thanhduy1806/BTL_DienTuUngDung/Report/loicamon.tex

\begin{center}
	{\fontsize{24pt}{24pt}\selectfont\textit{Lời cảm ơn}}
\end{center}

Chúng em xin gửi lời cảm ơn chân thành đến thầy Nguyễn Trung Hiếu vì đã hướng dẫn nhóm chúng em về kiến thức trong quá trình thực hiện mô phỏng mạch đo khối lượng
(tiểu ly) trong môn học Điện tử ứng dụng.\\

Nhờ sự tận tâm và nhiệt huyết của thầy, chúng em đã học hỏi được nhiều điều để
có hướng nghiên cứu phù hợp với đề tài hơn. Trong suốt thời gian nghiên cứu,
thầy không chỉ cung cấp cho chúng em những chỉ dẫn chi tiết và thiết thực mà
còn luôn sẵn sàng giải đáp những thắc mắc, giúp chúng em vượt qua những khó
khăn gặp phải. Sự tâm huyết của thầy trên giảng đường cũng như trong công việc
hướng dẫn đã truyền cảm hứng và động lực cho chúng em rất nhiều.\\

Chúng em xin chân thành cảm ơn thầy và chúc thầy luôn dồi dào sức khỏe, thành công
trong sự nghiệp giảng dạy và tiếp tục là ngọn đuốc soi sáng con đường học tập của
chúng em và các thế hệ sinh viên sau này.\\

Mặc dù nhóm đã rất nỗ lực trong quá trình thực hiện, báo cáo khó tránh
khỏi những thiếu sót. Chúng em rất mong nhận được sự góp ý và chỉ dẫn từ 
Thầy để đề tài được hoàn thiện hơn trong tương lai.
\begin{flushright}
    Thành phố Hồ Chí Minh, ngày \the\day\ tháng \the\month\ năm \the\year
\end{flushright}
