thanhduy1806/BTL_DienTuUngDung/Report/chuong6.tex

\chapter{Kết quả thực tế}
Chương 6 thể hiện kết quả đo đạc được từ mạch thực tế, trong điều kiện nhiệt độ 28$^\circ\text{C}$, từ đó so sánh với giá trị mô phỏng được.
\section{Tại khối lượng 0kg}

\begin{figure}[H]
    \centering
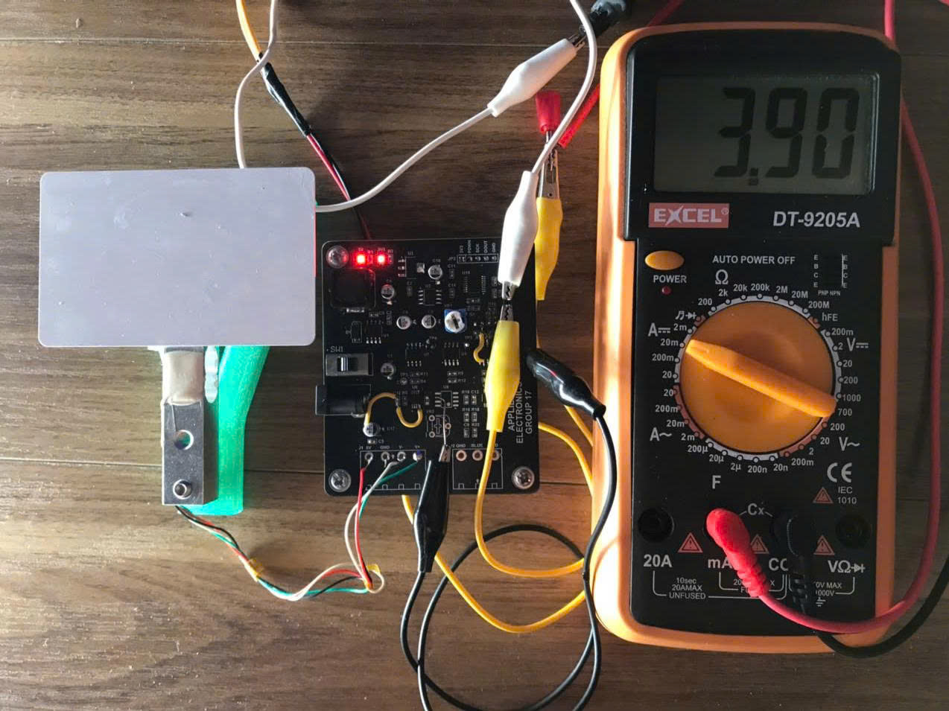
[picture p31: Report/image/real_0.jpg]
    
    \caption{Đo thực tế 0gam}
    \label{fig:real_0}
\end{figure}

\begin{figure}[H]
    \centering
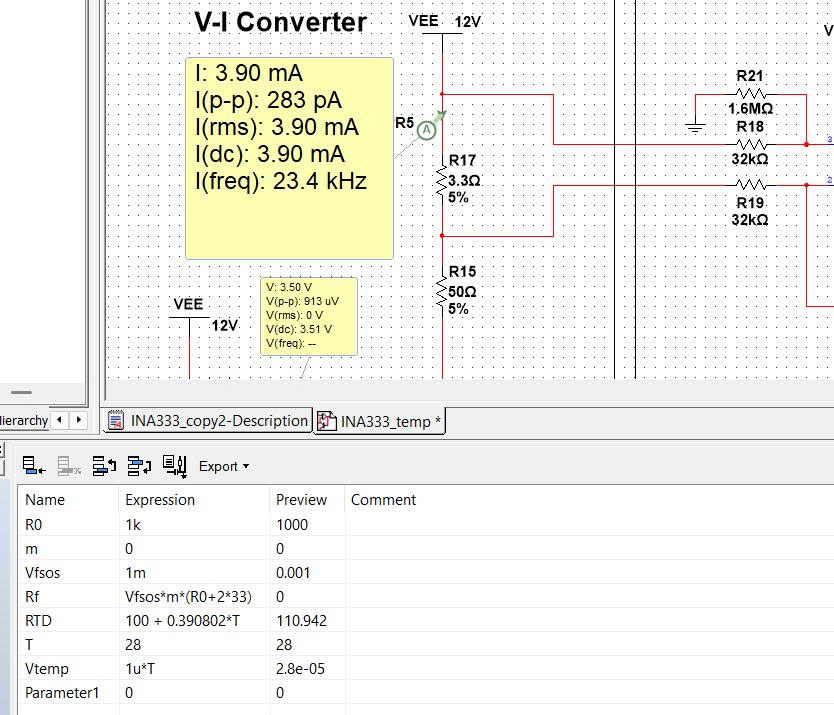
[picture p32: Report/image/sim_0.jpg]
    
    \caption{Mô phỏng 0gam}
    \label{fig:sim_0}
\end{figure}

\section{Tại khối lượng 1gam}

\begin{figure}[H]
    \centering
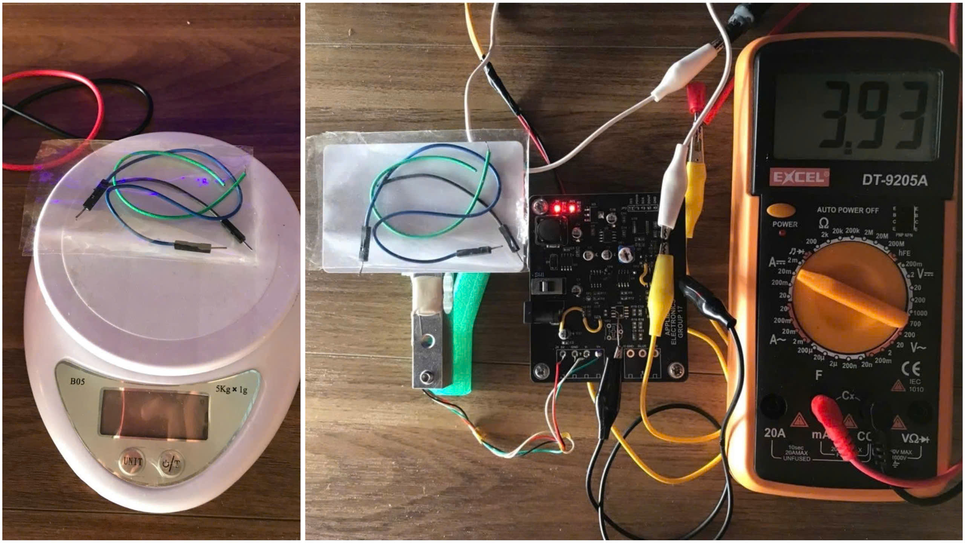
[picture p33: Report/image/real_1gam.jpg]
    
    \caption{Đo thực tế 1gam}
    \label{fig:real_0gam}
\end{figure}

\begin{figure}[H]
    \centering
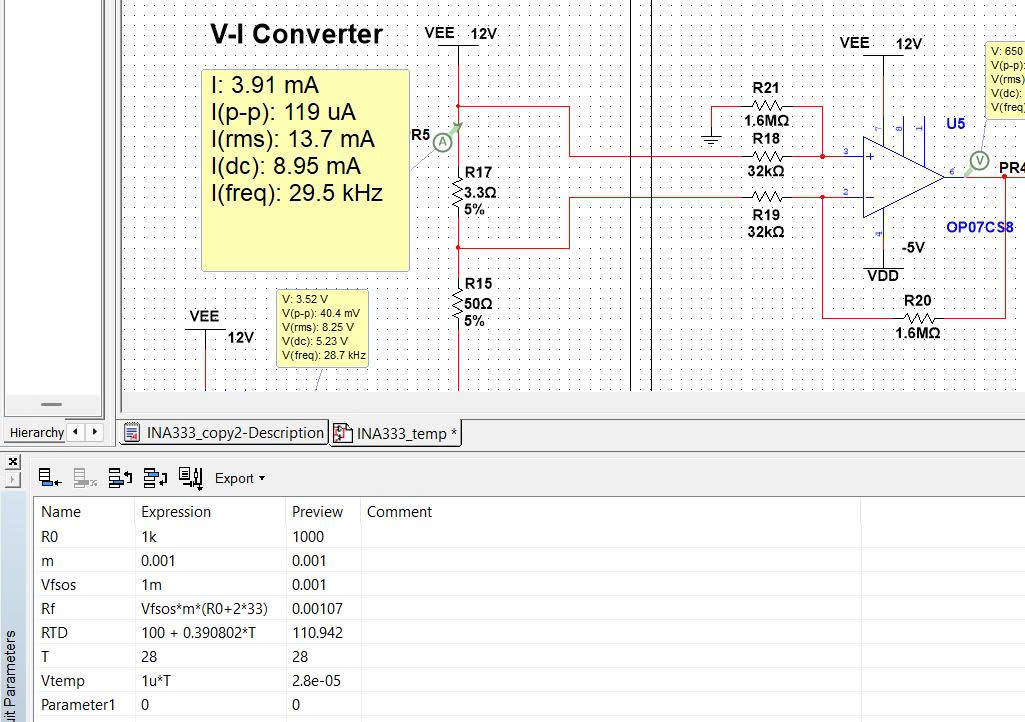
[picture p34: Report/image/sim_1gam.jpg]
    
    \caption{Mô phỏng 1gam}
    \label{fig:sim_1gam}
\end{figure}

\section{Tại khối lượng 3gam}

\begin{figure}[H]
    \centering
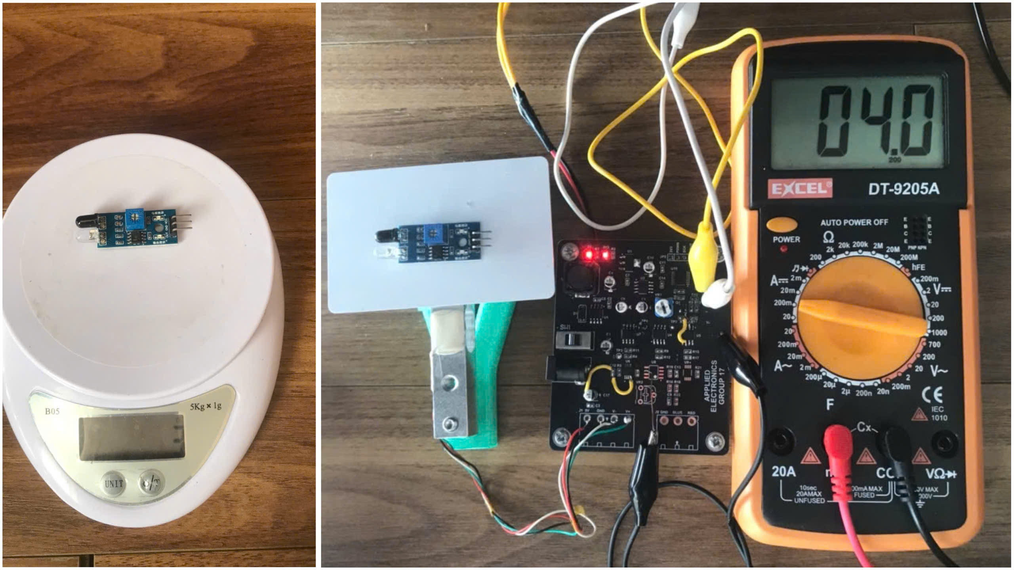
[picture p35: Report/image/real_3gam.jpg]
    
    \caption{Đo thực tế 3gam}
    \label{fig:real_3gam}
\end{figure}

\begin{figure}[H]
    \centering
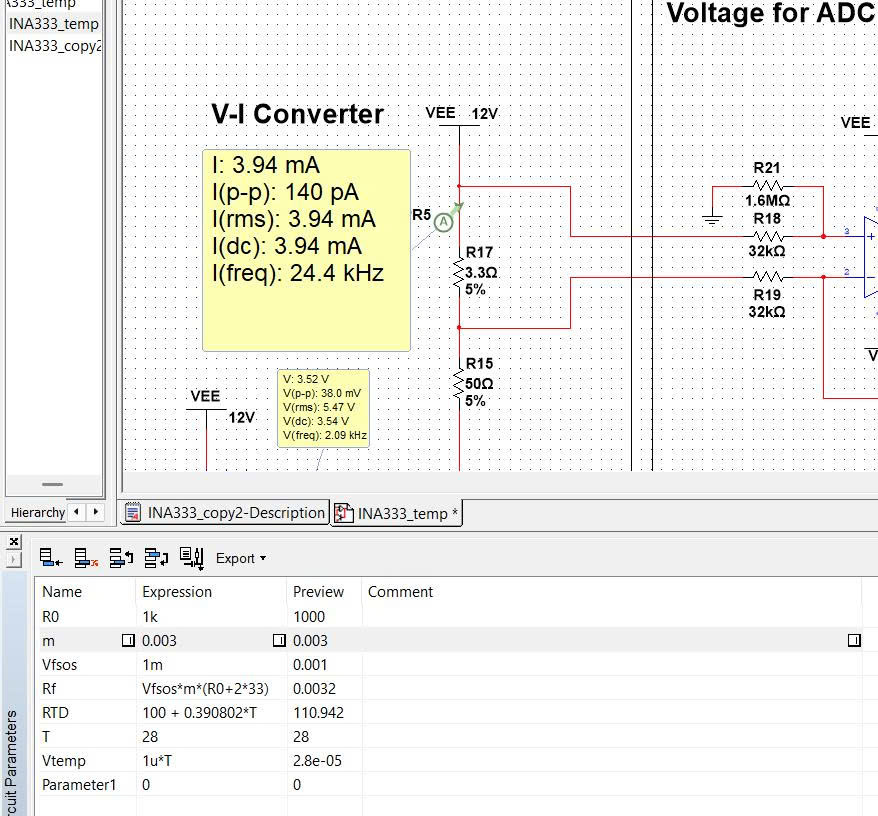
[picture p36: Report/image/sim_3gam.jpg]
    
    \caption{Mô phỏng 3gam}
    \label{fig:sim_3gam}
\end{figure}

\section{Tại khối lượng 81gam}

\begin{figure}[H]
    \centering
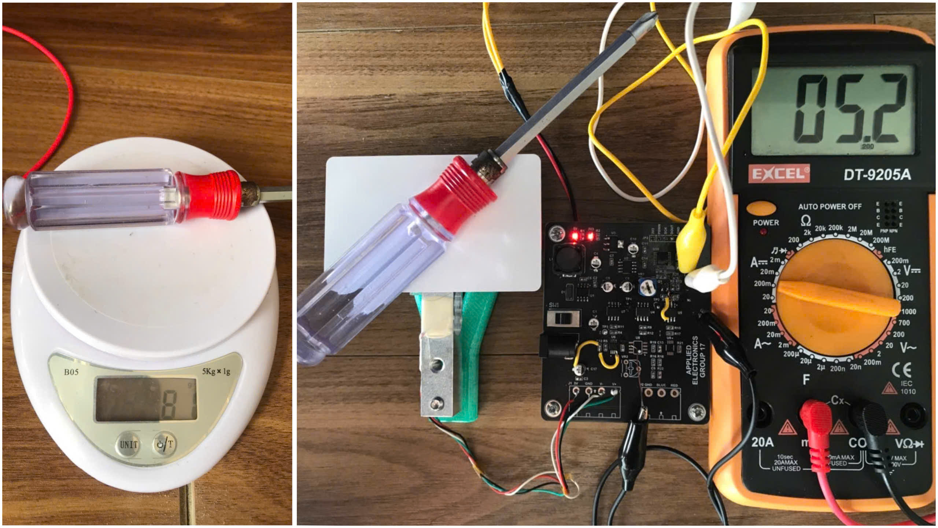
[picture p37: Report/image/real_81gam.jpg]
    
    \caption{Đo thực tế 81gam}
    \label{fig:real_81gam}
\end{figure}

\begin{figure}[H]
    \centering
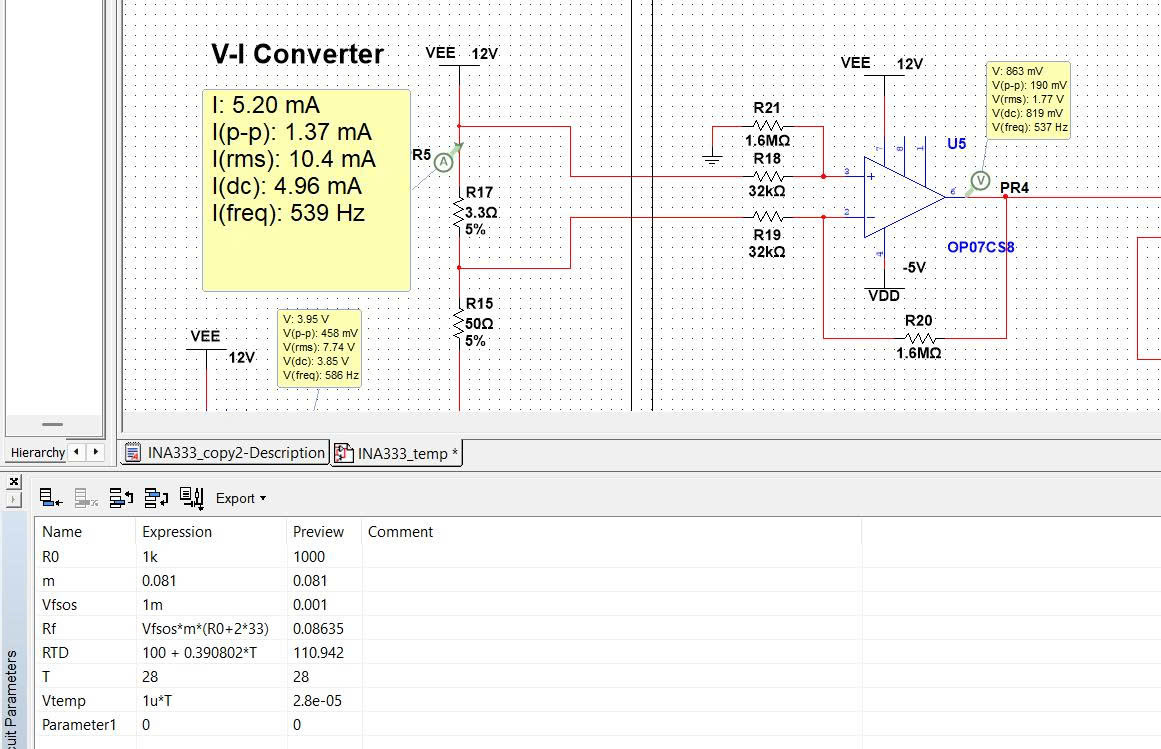
[picture p38: Report/image/sim_81gam.jpg]
    
    \caption{Mô phỏng 81gam}
    \label{fig:sim_81gam}
\end{figure}

\section{Tại khối lượng 95gam}

\begin{figure}[H]
    \centering
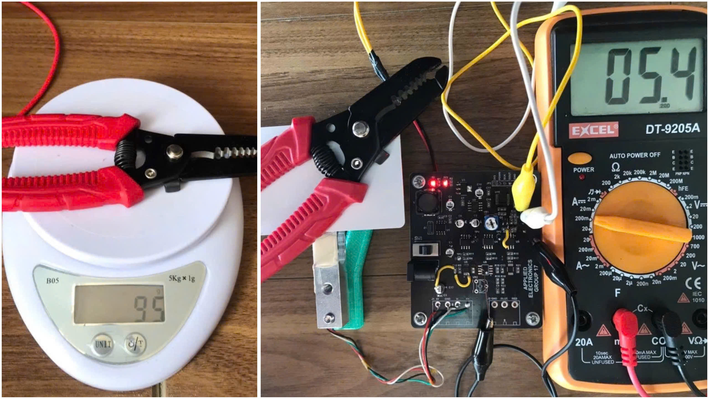
[picture p39: Report/image/real_95gam.jpg]
    
    \caption{Đo thực tế 95gam}
    \label{fig:real_95gam}
\end{figure}

\begin{figure}[H]
    \centering
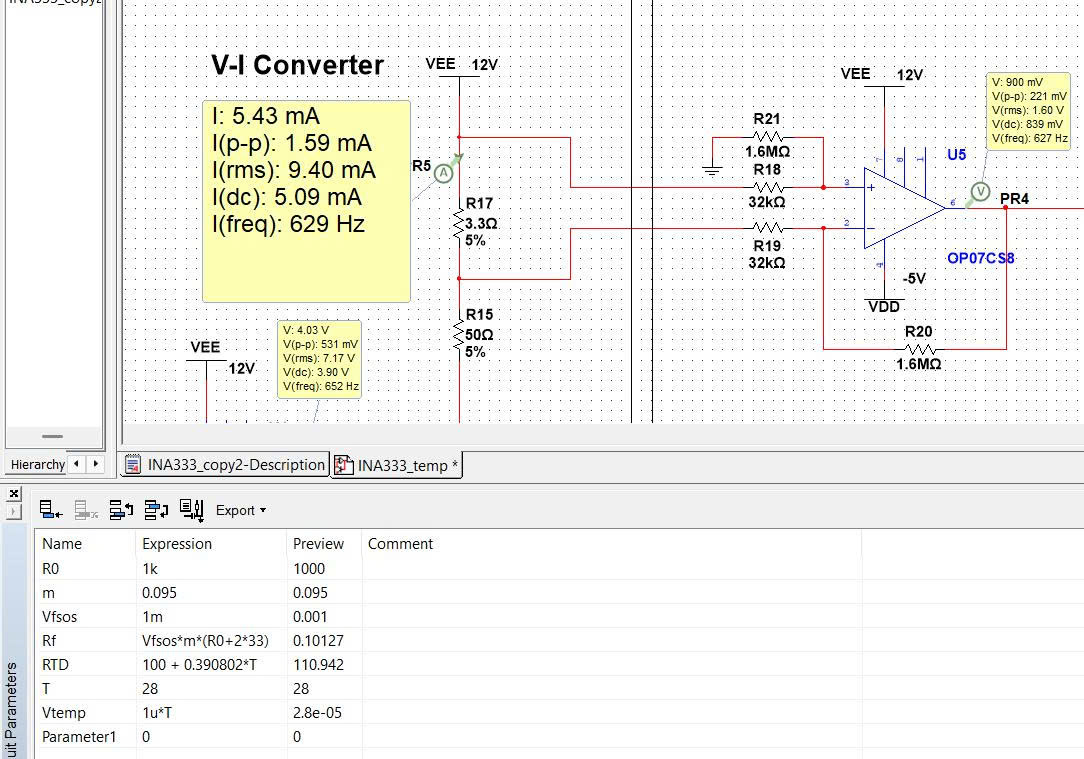
[picture p40: Report/image/sim_95gam.jpg]
    
    \caption{Mô phỏng 95gam}
    \label{fig:sim_95gam}
\end{figure}

\section{Tại khối lượng 100gam}

\begin{figure}[H]
    \centering
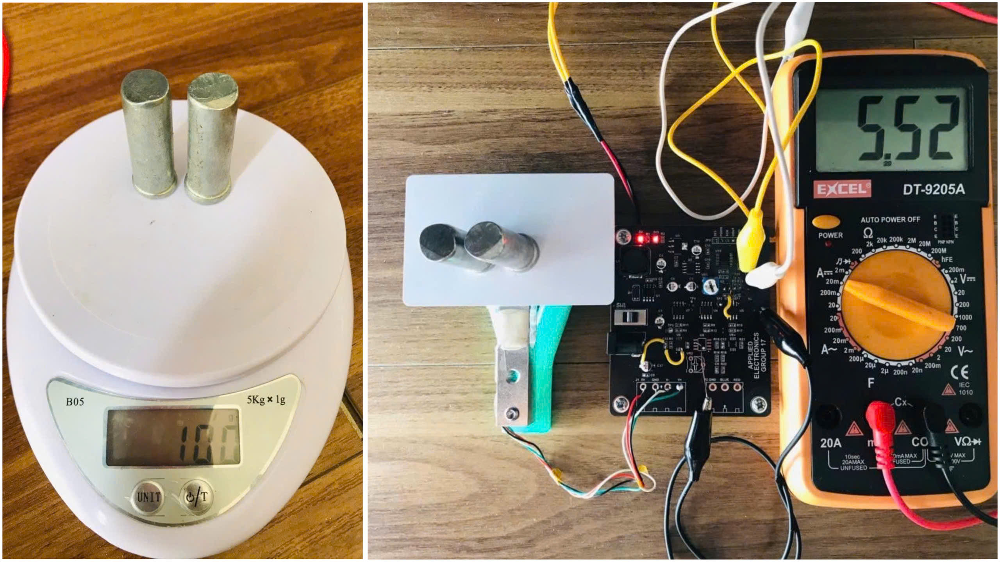
[picture p41: Report/image/real_100gam.jpg]
    
    \caption{Đo thực tế 100gam}
    \label{fig:real_100gam}
\end{figure}

\begin{figure}[H]
    \centering
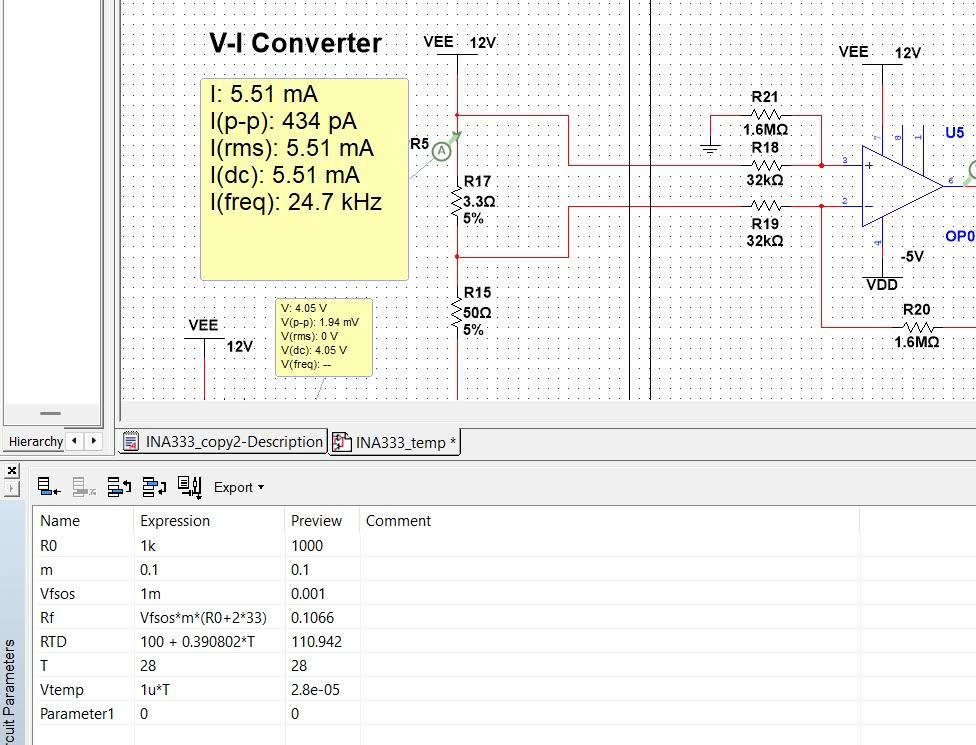
[picture p42: Report/image/sim_100gam.jpg]
    
    \caption{Mô phỏng 100gam}
    \label{fig:sim_100gam}
\end{figure}

\section{Tại khối lượng 163gam}

\begin{figure}[H]
    \centering
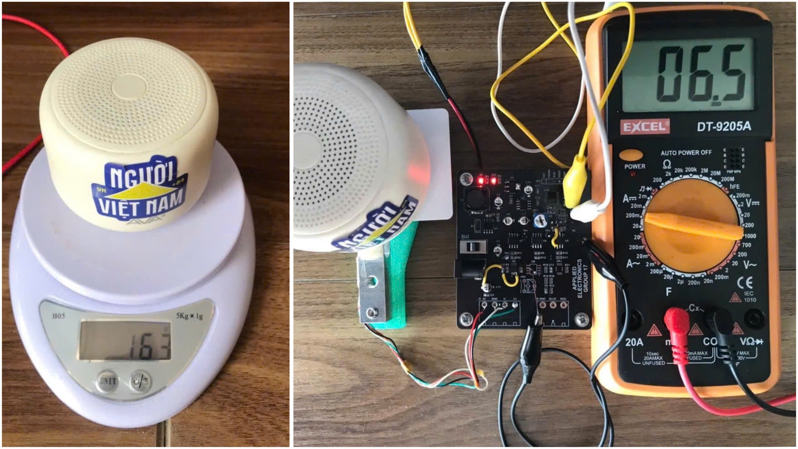
[picture p43: Report/image/real_163gam.jpg]
    
    \caption{Đo thực tế 163gam}
    \label{fig:real_163gam}
\end{figure}

\begin{figure}[H]
    \centering
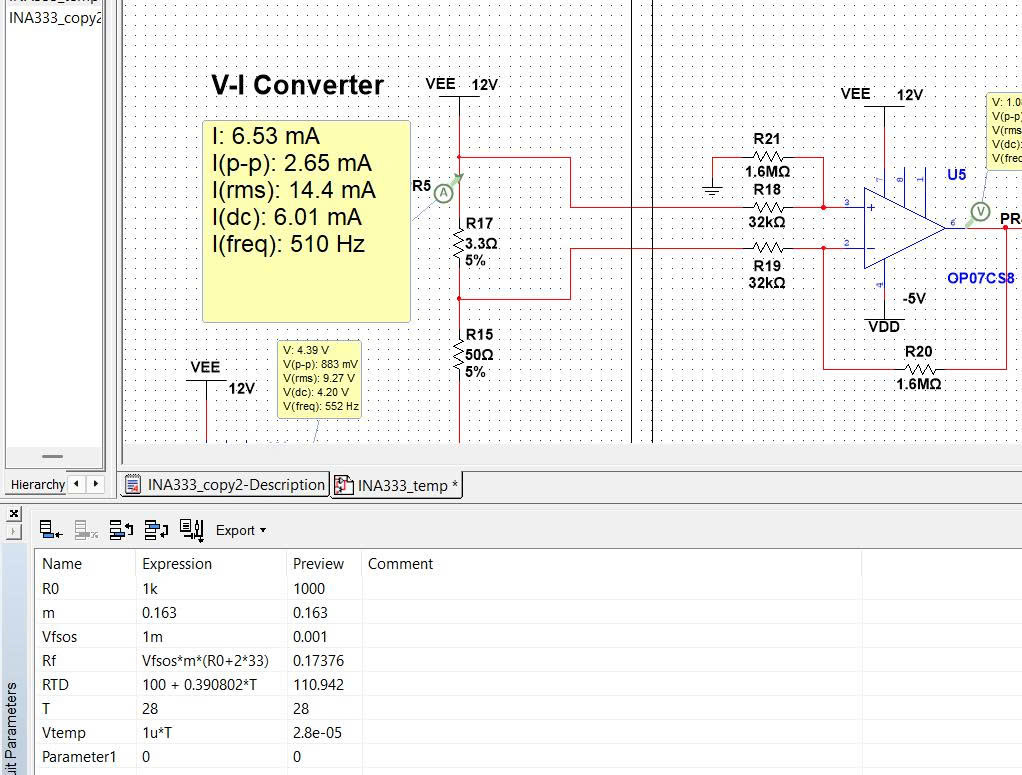
[picture p44: Report/image/sim_163gam.jpg]
    
    \caption{Mô phỏng 163gam}
    \label{fig:sim_163gam}
\end{figure}

\section{Tại khối lượng 243gam}

\begin{figure}[H]
    \centering
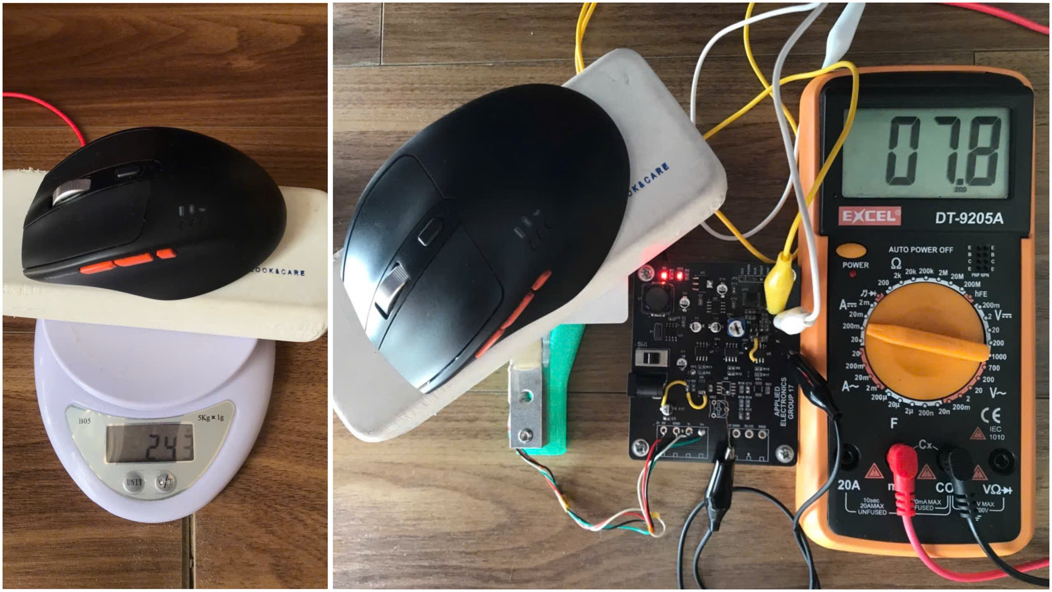
[picture p45: Report/image/real_243gam.jpg]
    
    \caption{Đo thực tế 243gam}
    \label{fig:real_243gam}
\end{figure}

\begin{figure}[H]
    \centering
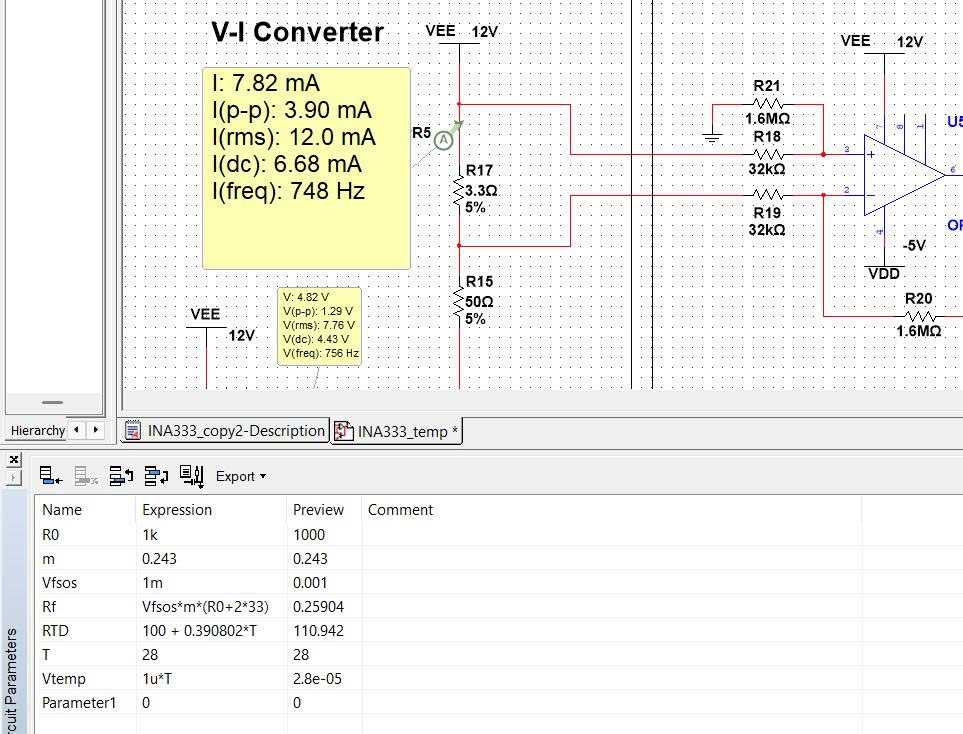
[picture p46: Report/image/sim_243gam.jpg]
    
    \caption{Mô phỏng 243gam}
    \label{fig:sim_243gam}
\end{figure}

\section{Tại khối lượng 357gam}

\begin{figure}[H]
    \centering
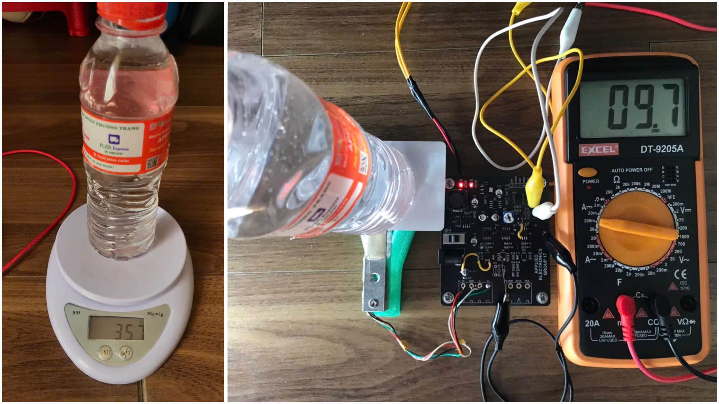
[picture p47: Report/image/real_357gam.jpg]
    
    \caption{Đo thực tế 357gam}
    \label{fig:real_357gam}
\end{figure}

\begin{figure}[H]
    \centering
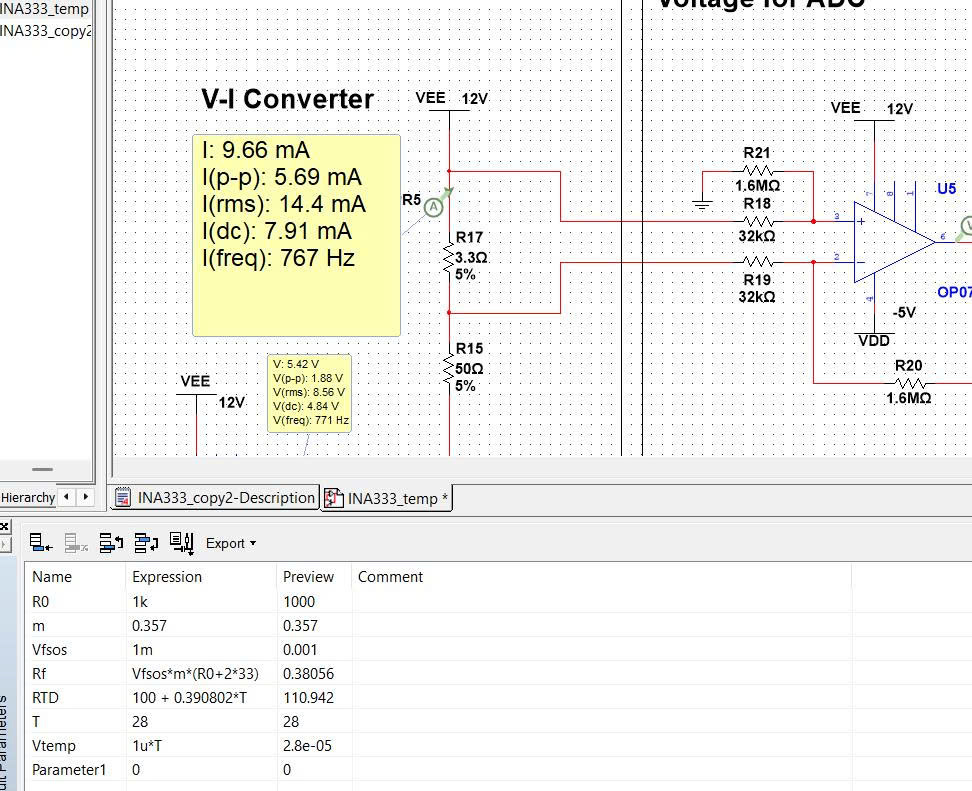
[picture p48: Report/image/sim_357gam.jpg]
    
    \caption{Mô phỏng 357gam}
    \label{fig:sim_357gam}
\end{figure}

\section{Tại khối lượng 501gam}

\begin{figure}[H]
    \centering
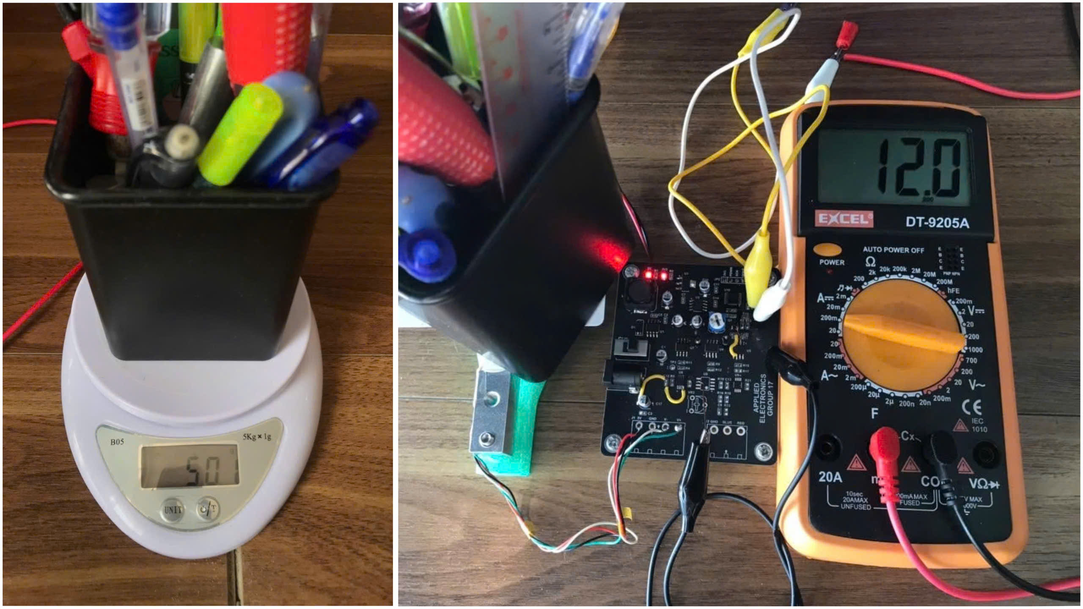
[picture p49: Report/image/real_501gam.jpg]
    
    \caption{Đo thực tế 501gam}
    \label{fig:real_501gam}
\end{figure}

\begin{figure}[H]
    \centering
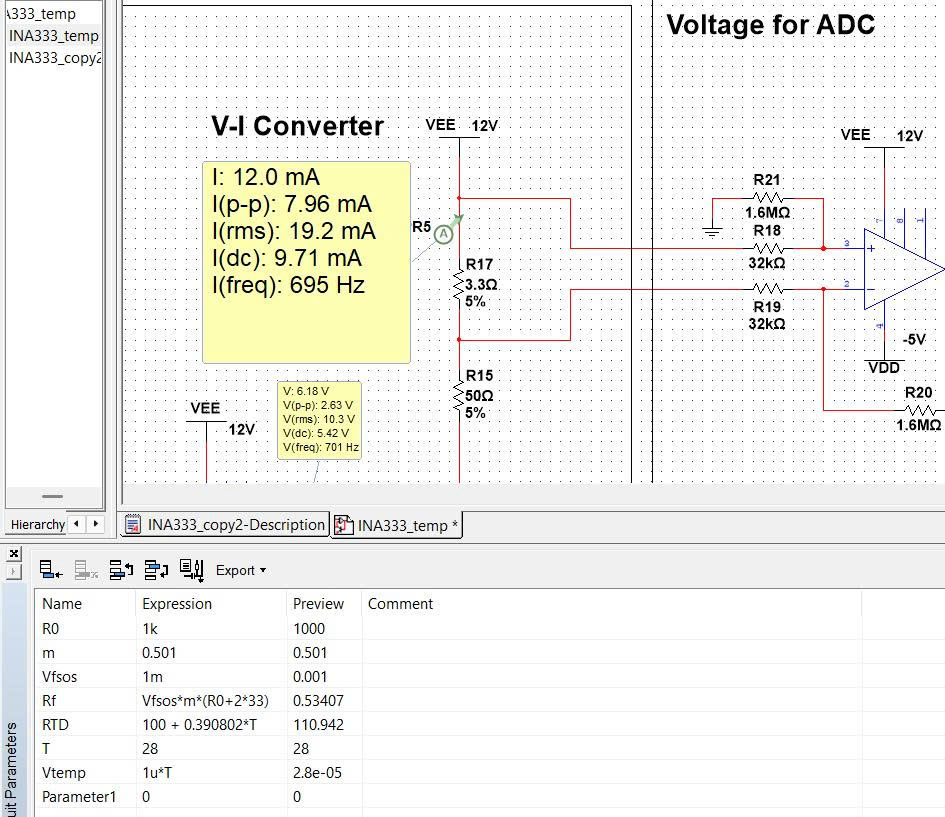
[picture p50: Report/image/sim_501gam.jpg]
    
    \caption{Mô phỏng 501gam}
    \label{fig:sim_501gam}
\end{figure}

\section{Tại khối lượng 1kg}

\begin{figure}[H]
    \centering
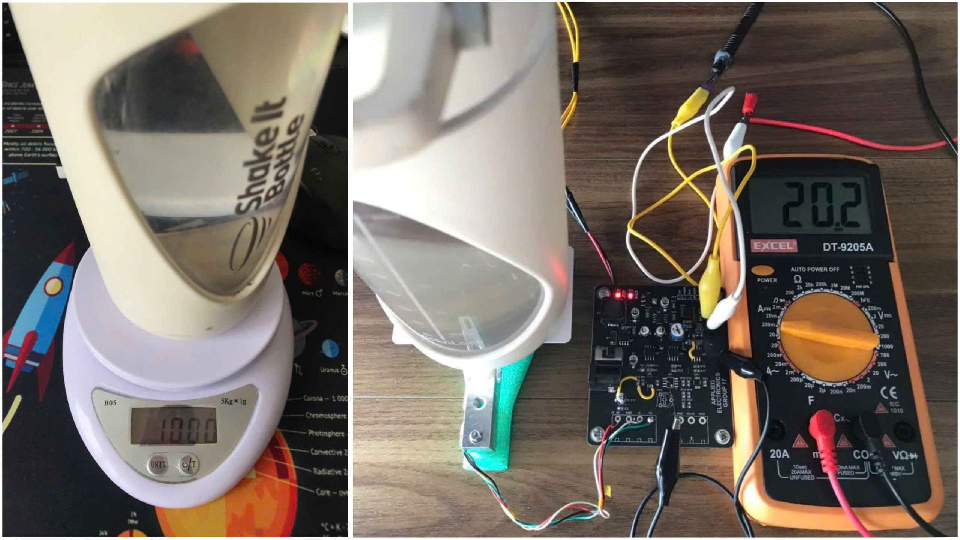
[picture p51: Report/image/real_1kg.jpg]
    
    \caption{Đo thực tế 1000gam}
    \label{fig:real_1kg}
\end{figure}

\begin{figure}[H]
    \centering
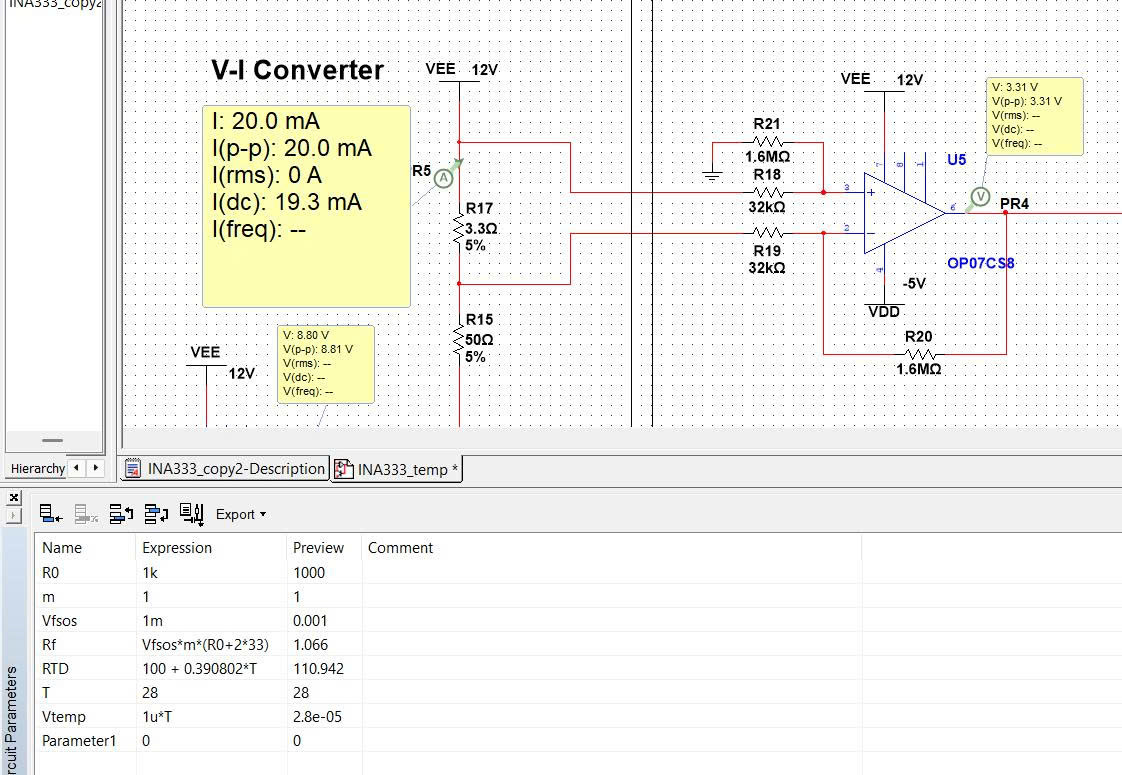
[picture p52: Report/image/sim_1kg.jpg]
    
    \caption{Mô phỏng 1000gam}
    \label{fig:sim_1kg}
\end{figure}

\section{Đánh giá kết quả}
Từ hình ảnh đo đạc thực tế qua việc tham chiếu với cân điện tử và so sánh với mô phỏng, có thể thấy được mạch hoạt động ổn định và cho kết quả tương đối chính xác, bên cạnh đó còn một số kết quả có sai lệch, ví dụ như tại 1000 gam thì kết quả đo đạc được dòng ngõ ra là 20.2 mA kết quả này sai lệch so với lý thuyết là 0.2mA, hoặc tại 357 gam thì thực tế đọc được là 9.7 mA còn mô phỏng là 9.66 mA, sai lệch khoảng 0.4 mA. Tổng quan kết quả có thể tạm chấp nhận được với những sai số tương đối, từ đó có thể thấy được phần cứng được thiết kế là chưa hoàn toàn tối ưu và không thể tránh được những sai số nhưng có thể vẫn chấp nhận được và sẽ có những giải pháp khắc phục bằng cách thiết kế lại phần cứng từ kinh nghiệm sẵn có, điều chỉnh lại trong quá trình cân lại loadcell và xử lý tính toán lại bằng giải pháp phần mềm.
