thanhduy1806/BTL_DienTuUngDung/Report/main.tex

\documentclass[12pt, a4paper, fleqn]{extreport}
\usepackage[utf8]{vietnam}
\usepackage{amsmath,amsfonts,amssymb}
\usepackage{graphicx, float}
\usepackage[left=3cm, right=2cm, top=2cm, bottom=2cm]{geometry}
\usepackage{setspace}
\usepackage{array, booktabs, subcaption}
\usepackage{tabularx}
\usepackage{caption} % Để dùng được lệnh \caption* không đánh số
\usepackage{titlesec}
\usepackage{fancyhdr}
\usepackage{tikz}
\usetikzlibrary{calc,positioning,shapes,arrows}
\usepackage{tocloft} % Điều chỉnh spacing cho TOC/LOF/LOT
\usepackage{indentfirst}
\usepackage[hidelinks]{hyperref} % Hyperlink nên đặt ở cuối cùng
\usepackage{float}
\usepackage{pdfpages}

% --- Font size & line spacing ---
\renewcommand{\normalsize}{\fontsize{13}{16}\selectfont} % font 13pt, dòng 16pt
\setstretch{1.1} % khoảng cách dòng

% --- Header & Footer ---
\pagestyle{fancy}
\fancyhf{}
\fancyhead[R]{\textit{GVHD: ThS. Nguyễn Trung Hiếu}}
\fancyfoot[R]{Trang $\mid$ \thepage}

\fancypagestyle{plain}{
    \fancyhf{}
    \fancyhead[R]{\textit{GVHD: ThS. Nguyễn Trung Hiếu}}
    \fancyfoot[R]{Trang $\mid$ \thepage}
}

\setlength{\headheight}{25pt}
\setlength{\footskip}{20pt}
\setlength{\parindent}{35pt}

% --- TOC / LOF / LOT spacing ---
\setlength{\cftbeforetoctitleskip}{0pt}  % khoảng cách trước tiêu đề TOC
\setlength{\cftaftertoctitleskip}{10pt}  % khoảng cách sau tiêu đề TOC

\setlength{\cftbeforeloftitleskip}{0pt}  % trước LOF
\setlength{\cftafterloftitleskip}{10pt}  % sau LOF

\setlength{\cftbeforelottitleskip}{0pt}  % trước LOT
\setlength{\cftafterlottitleskip}{10pt}  % sau LOT

% --- Chapter style ---
\titleformat{\chapter}[block]
{\normalfont\LARGE\bfseries\raggedright}
{CHƯƠNG \thechapter}{1em}
{\rule{\textwidth}{0.5pt}\vspace{0.4em}\\\raggedright}
[\rule{\textwidth}{0.5pt}]
\titlespacing*{\chapter}{0pt}{-10pt}{20pt} 

\begin{document}

% --- Trang bìa & lời cảm ơn ---
\pagenumbering{gobble} 
\input{titlepage}
\cleardoublepage

      % Ngắt trang sạch sẽ
\input{nhiemvu}      % <--- CHÈN BẢNG CỦA BẠN VÀO ĐÂY
\cleardoublepage 

\pagenumbering{arabic}
\input{loicamon}

% --- TOC / LOF / LOT ---
\cleardoublepage
\tableofcontents
\cleardoublepage
\listoffigures
\cleardoublepage
\listoftables

% --- Nội dung chương ---
\cleardoublepage
\input{chuong1}

\newpage
\input{chuong2}

\newpage
\input{chuong3}

\newpage
\input{chuong4}

\newpage
\input{chuong5}

\newpage
\input{chuong6}

\newpage
\input{ketluanchung}

\end{document}
