thanhduy1806/BTL_DienTuUngDung/Report/image/sim_0kg.jpg

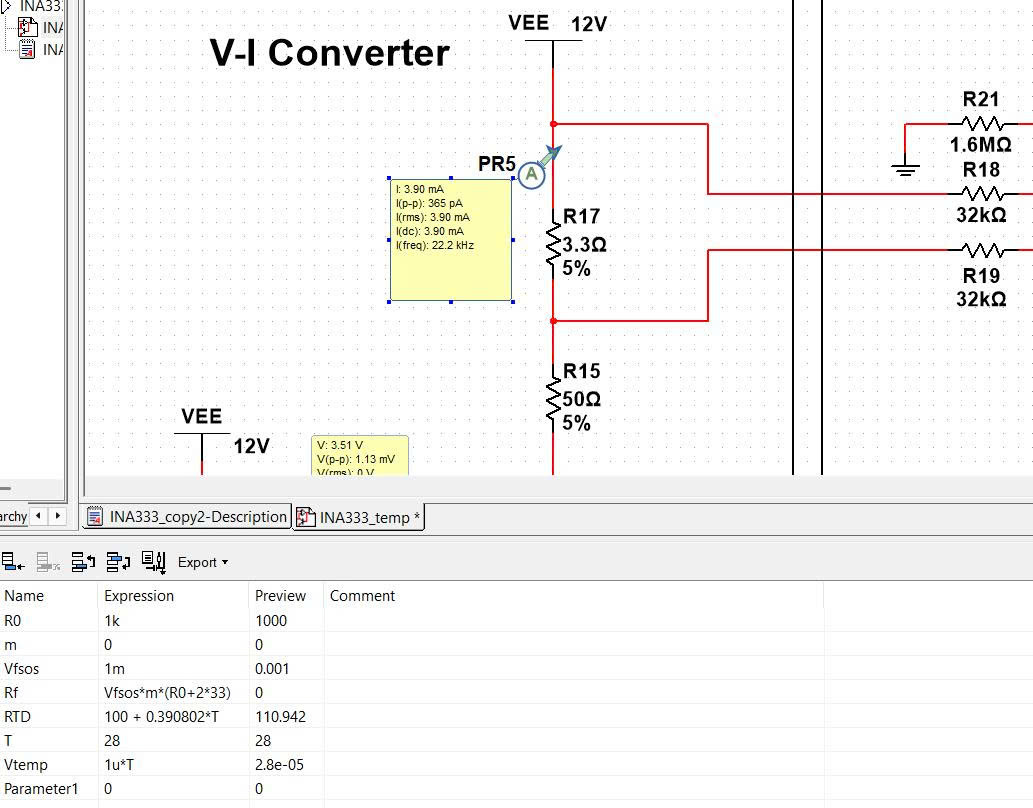
Report/image/sim_0kg.jpg
