thanhduy1806/BTL_DienTuUngDung/(list of files, drawings)

Other design files:
LoadcellBoard/01_DESIGN/Loadcell/Loadcell.PrjPcb
LoadcellBoard/01_DESIGN/Loadcell/loadcell.SchDoc
LoadcellBoard/01_DESIGN/Loadcell/PCB2.PcbDoc
LoadcellBoard/01_DESIGN/Loadcell/PcbLib.PcbLib
LoadcellBoard/01_DESIGN/Loadcell/power.SchDoc
LoadcellBoard/01_DESIGN/Loadcell/Schlib.SchLib
MoPhong/BTL_ADC_19bits.ms14
MoPhong/INA333.ms14
MoPhong/INA333_temp.ms14
Samy_PCB/Loadcell/Loadcell.PrjPcb
Samy_PCB/Loadcell/LOADCELL.SchDoc
Samy_PCB/Loadcell/Loadcell.SCHLIB
Samy_PCB/Loadcell/PCB1.PcbDoc
Samy_PCB/Loadcell/PCB1.PcbLib
Samy_PCB/Loadcell/POWER.SchDoc
