thanhduy1806/BTL_DienTuUngDung/(commit log)

2025-11-24 Add simulation file
    This commit adds first design of simulation file.
    The output is 4-20mA for now and need to update to
    convert curent to voltage 0-3.3V.
    [INA333.ms14]
2025-11-25 update ADC 19bits simulator
    [BTL_ADC_19bits.ms14]
2025-11-25 Convert dòng thành áp
    Commit này update thêm mạch đo dòng để đưa dòng thành áp.
    Tuy nhiên vì dòng bắt đầu từ 4mA nên không thể đưa áp về 0
    hoàn toàn được mà áp sẽ được đổi thành 0.66V tại 4mA.
    Còn 20mA thì đổi thành áp 3.3 bình thường.
    [INA333.ms14]
2025-11-26 Thêm Report
    Commit này init Report bao gồm trang bìa và main
2025-11-26 Update trang mục lục, danh sách hình/bảng và thêm lời cảm ơn
2025-11-27 Update file mô phỏng có bù nhiệt
    Update thêm 1 file mô phỏng đã thêm bù nhiệt.
    - Cần đổi con INA của bù nhiệt thành con khuếch đại vi sai,
    chọn 4 con trở bằng nhau
    - Vẽ khung cho từng khối
    [INA333_temp.ms14]
2025-11-28 Update file INA333_Temp
    [INA333_temp.ms14]
2025-11-29 Done 3.3. Mạch đo dòng
2025-11-29 Update mạch INA333_temp
    [INA333_temp.ms14]
2025-11-29 Fix khoảng điện áp
    Vì điện áp không chạy từ 0-3.3V mà chạy từ 0.6-3.3V
    nên cần sửa đổi lại.
    [BTL_ADC_19bits.ms14]
2025-11-30 thêm phần lí thuyết về bù nhiệt, giải thích mạch mô phỏng
2025-11-30 xóa 'Với khối lượng là 0kg, điện áp ngõ ra đo được là 0.65mV.' bị sai
2025-11-30 update kết luận chung cho toàn báo cáo
2025-11-30 update lại hình bộ ADC lúc mới tạo
2025-11-30 chỉnh sửa vài chỗ trong mô phỏng
    [BTL_ADC_19bits.ms14]
2025-11-30 Update Rg cho INA333 RTD thành 1M
    [INA333_temp.ms14]
2025-12-07 create new folder Loadcellboard and sche in this
    [Loadcell.PrjPcb, PcbLib.PcbLib, Schlib.SchLib, loadcell.SchDoc, power.SchDoc]
2025-12-10 ignore build files
    [Loadcell.PrjPcb, PCB2.PcbDoc]
2025-12-10 new version
    [Loadcell.PrjPcb, POWER.SchDoc]
2025-12-10 Done Power but the Loadcell hasn't done yet
    [LOADCELL.SchDoc, Loadcell.PrjPcb, POWER.SchDoc]
2025-12-12 Add lib for project
    [Loadcell.SCHLIB, PCB11.PcbLib]
2025-12-12 Done Schematic and start layout PCB
    [LOADCELL.SchDoc, Loadcell.PrjPcb, PCB1.PcbDoc, POWER.SchDoc]
2025-12-13 Xếp linh kiện xong, update lib PCB
    [LOADCELL.SchDoc, Loadcell.PrjPcb, PCB1.PcbDoc, PCB1.PcbLib, PCB11.PcbLib]
2025-12-13 Done 80% layout
    [LOADCELL.SchDoc, PCB1.PcbDoc, POWER.SchDoc]
2025-12-14 Done PCB
    [Loadcell.PrjPcb, PCB1.PcbLib]
2025-12-14 change template sheet
    [LOADCELL.SchDoc]
2025-12-15 Add power switch
    [POWER.SchDoc]
2026-01-01 thêm bảng số liệu mô phỏng, phân công nhiệm vụ
2026-01-02 thêm chương thực hiện phần cứng
    [LOADCELL.SchDoc]
2026-01-02 thêm chương 7, đánh giá thực tế so với mô phỏng
2026-01-03 cập nhật kết luận và phần hạn chế khi chưa sử dụng bù nhiệt
2026-01-04 update nhiệm vụ của Samy
2026-01-04 chỉnh sửa kết luận ppt
2026-01-04 sửa slide, cập nhật nhiệm vụ
2026-01-04 thêm bảng decode, thêm hình phần hạn chế của phần cứng
2026-01-04 thêm nhiệm vụ của Phát
